gtalusan/coffeemaker/brew.jpg

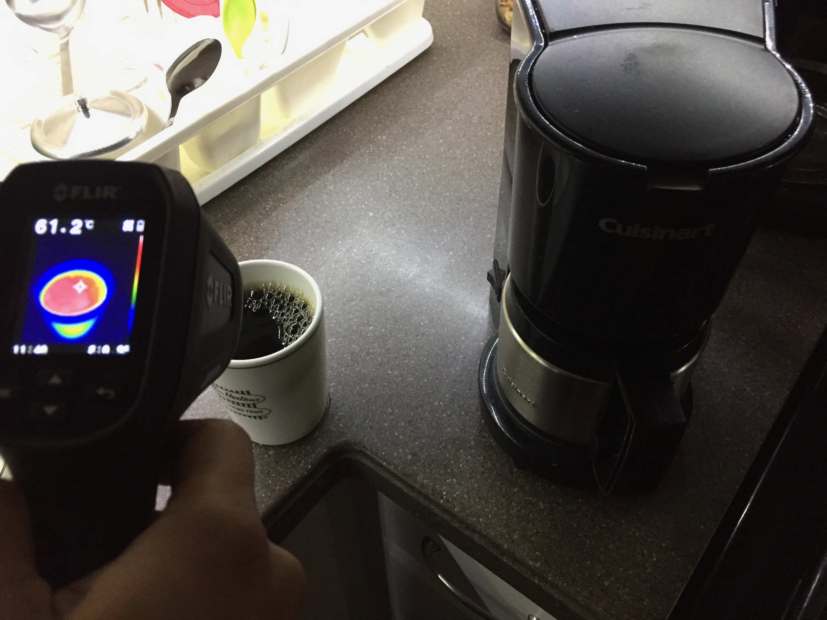
brew.jpg
